chipmc/Trail-Traffic-Counter-Board-v10/Trail-Traffic-Counter-Board-v10.brd

## EAGLE design Trail-Traffic-Counter-Board-v10.brd (2017-07-19)

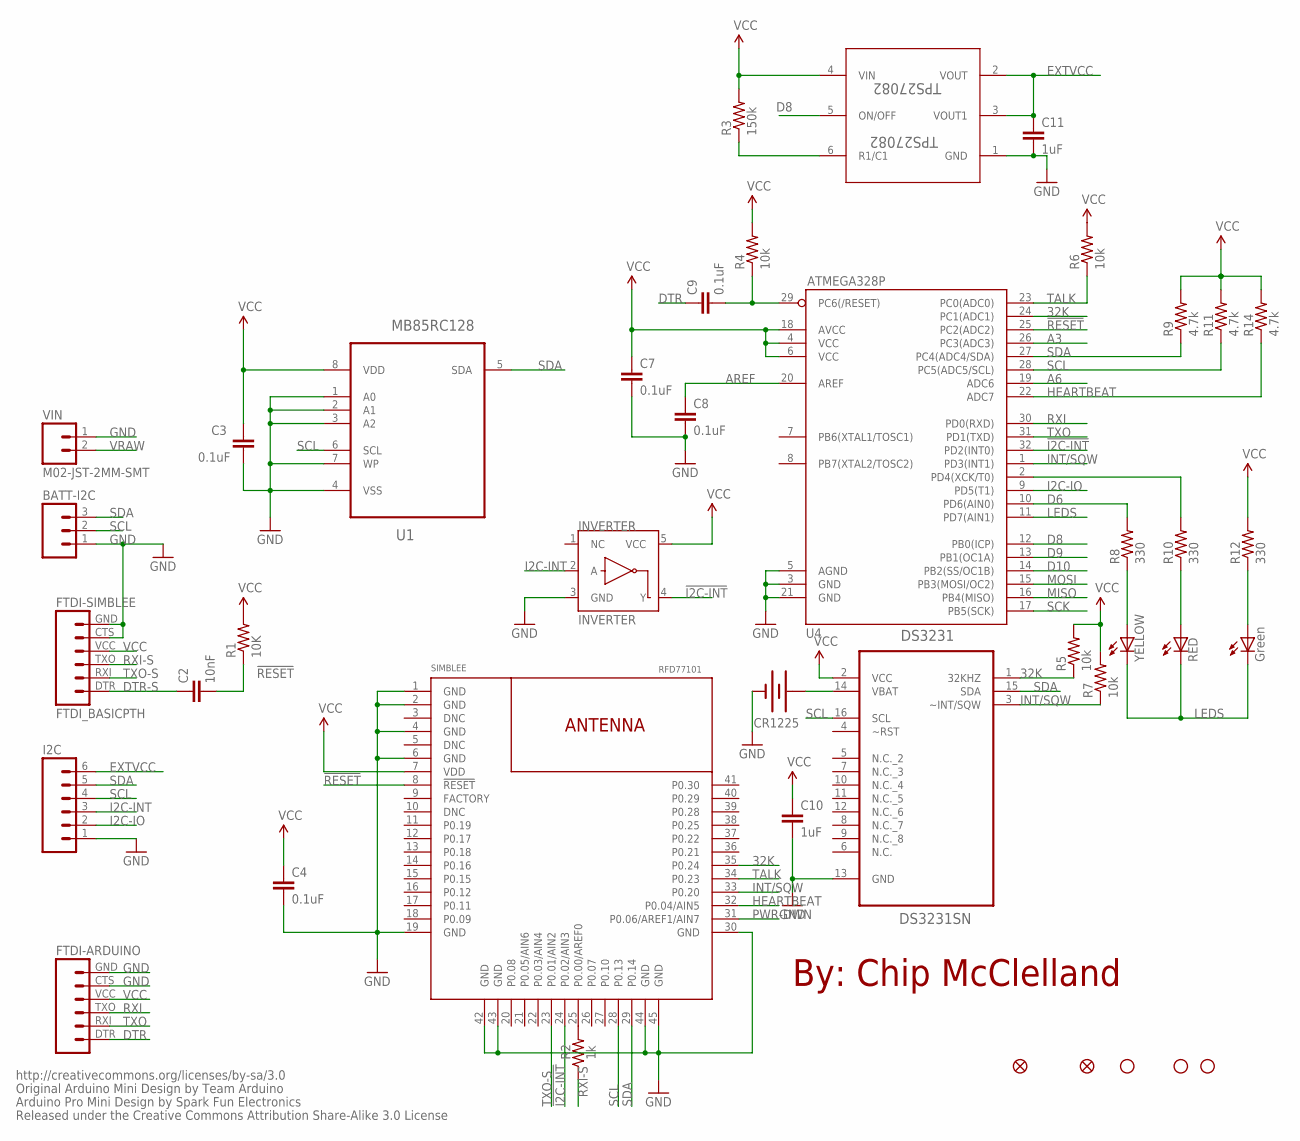
[picture p1: schematic Trail-Traffic-Counter-Board-v10.sch, sheet 1]

Parts:
ATMEGA328P: U4; TQFP32-08
BATT-I2C: M03LOCK; 1X03_LOCK
C2: 10nF; 0805
C3, C4, C7, C8, C9: 0.1uF; 0805
C10, C11: 1uF; 0805
CR1225: BATTERY12MM; BATTCON_12MM
DS3231: DS3231SN; SOIC127P1032X265-16N
FID1, FID2: FIDUCIALUFIDUCIAL; MICRO-FIDUCIAL
FTDI-ARDUINO: FTDI Basic; FTDI_BASIC
FTDI-SIMBLEE: FTDI_BASICPTH; FTDI_BASIC
I2C: M06LOCK; 1X06_LOCK
INVERTER: INVERTER; SOT23-5
JP6, JP7, JP8: STAND-OFF
LED1: YELLOW; CHIPLED_0805
LED2: RED; CHIPLED_0805
MB85RC128: U1; SOIC127P600X175-8N
PWR: Green; CHIPLED_0805
R1: 10K; 0805
R2: 1k; 0805
R3: 150k; 0805
R4, R5, R6, R7: 10k; 0805
R8, R10, R12: 330; 0603-RES
R9, R11, R14: 4.7k; 0805
SIMBLEE: RFD77101
TPS27082: TPS27082; TSOT-23
VIN: M02-JST-2MM-SMT; JST-2-SMD

Connections:
32K: ATMEGA328P.24 (PC1(ADC1)), DS3231.1 (32KHZ), R5.1, SIMBLEE.35 (P0.24)
!I2C-INT: ATMEGA328P.32 (PD2(INT0)), INVERTER.4 (Y), SIMBLEE.24 (P0.02/AIN3)
!RESET: ATMEGA328P.25 (PC2(ADC2)), C2.2, R1.1, SIMBLEE.8 (!RESET!)
A3: ATMEGA328P.26 (PC3(ADC3))
A6: ATMEGA328P.19 (ADC6)
AREF: ATMEGA328P.20 (AREF), C8.1
D6: ATMEGA328P.10 (PD6(AIN0)), R8.2
D8: ATMEGA328P.12 (PB0(ICP)), TPS27082.5 (ON/OFF)
D9: ATMEGA328P.13 (PB1(OC1A))
D10: ATMEGA328P.14 (PB2(SS/OC1B))
DTR: C9.1, FTDI-ARDUINO.DTR (1)
DTR-S: C2.1, FTDI-SIMBLEE.DTR (1)
EXTVCC: C11.1, I2C.6, TPS27082.2 (VOUT), TPS27082.3 (VOUT1)
GND: ATMEGA328P.3 (GND), ATMEGA328P.5 (AGND), ATMEGA328P.21 (GND), BATT-I2C.1, C3.2, C4.2, C7.2, C8.2, C10.2, C11.2, CR1225.GND (-), DS3231.13 (GND), FTDI-ARDUINO.CTS (5), FTDI-ARDUINO.GND (6), FTDI-SIMBLEE.CTS (5), FTDI-SIMBLEE.GND (6), I2C.1, INVERTER.3 (GND), MB85RC128.1 (A0), MB85RC128.2 (A1), MB85RC128.3 (A2), MB85RC128.4 (VSS), MB85RC128.7 (WP), SIMBLEE.1 (GND), SIMBLEE.2 (GND), SIMBLEE.4 (GND), SIMBLEE.6 (GND), SIMBLEE.19 (GND), SIMBLEE.30 (GND), SIMBLEE.42 (GND), SIMBLEE.43 (GND), SIMBLEE.44 (GND), SIMBLEE.45 (GND), TPS27082.1 (GND), VIN.1 (2); also elsewhere on the board
HEARTBEAT: ATMEGA328P.22 (ADC7), R14.1, SIMBLEE.32 (P0.04/AIN5)
I2C-INT: I2C.3, INVERTER.2 (A)
I2C-IO: ATMEGA328P.9 (PD5(T1)), I2C.2
INT/SQW: ATMEGA328P.1 (PD3(INT1)), DS3231.3 (~INT/SQW), R7.1, SIMBLEE.33 (P0.20)
LEDS: ATMEGA328P.11 (PD7(AIN1)), LED1.C, LED2.C, PWR.C
MISO: ATMEGA328P.16 (PB4(MISO))
MOSI: ATMEGA328P.15 (PB3(MOSI/OC2))
unnamed: LED1.A, R8.1
unnamed: ATMEGA328P.2 (PD4(XCK/T0)), R10.2
unnamed: LED2.A, R10.1
unnamed: R3.1, TPS27082.6 (R1/C1)
unnamed: R2.2, SIMBLEE.25 (P0.00/AREF0)
unnamed: PWR.A, R12.1
PWR-DWN: SIMBLEE.31 (P0.06/AREF1/AIN7); also elsewhere on the board
RESET: ATMEGA328P.29 (PC6(/RESET)), C9.2, R4.1
RXI: ATMEGA328P.30 (PD0(RXD)), FTDI-ARDUINO.TXO (3)
RXI-S: FTDI-SIMBLEE.TXO (3), R2.1
SCK: ATMEGA328P.17 (PB5(SCK))
SCL: ATMEGA328P.28 (PC5(ADC5/SCL)), BATT-I2C.2, DS3231.16 (SCL), I2C.4, MB85RC128.6 (SCL), R11.1, SIMBLEE.28 (P0.13)
SDA: ATMEGA328P.27 (PC4(ADC4/SDA)), BATT-I2C.3, DS3231.15 (SDA), I2C.5, MB85RC128.5 (SDA), R9.1, SIMBLEE.29 (P0.14)
TALK: ATMEGA328P.23 (PC0(ADC0)), R6.1, SIMBLEE.34 (P0.23)
TXO: ATMEGA328P.31 (PD1(TXD)), FTDI-ARDUINO.RXI (2)
TXO-S: FTDI-SIMBLEE.RXI (2), SIMBLEE.23 (P0.01/AIN2)
VBAT: CR1225.PWR@1 (+), DS3231.14 (VBAT)
VCC: ATMEGA328P.4 (VCC), ATMEGA328P.6 (VCC), ATMEGA328P.18 (AVCC), C3.1, C4.1, C7.1, C10.1, DS3231.2 (VCC), FTDI-ARDUINO.VCC (4), FTDI-SIMBLEE.VCC (4), INVERTER.5 (VCC), MB85RC128.8 (VDD), R1.2, R3.2, R4.2, R5.2, R6.2, R7.2, R9.2, R11.2, R12.2, R14.2, SIMBLEE.7 (VDD), TPS27082.4 (VIN); also elsewhere on the board
VRAW: VIN.2 (1); also elsewhere on the board

Notes on the sheet:
Released under the Creative Commons Attribution Share-Alike 3.0 License
http://creativecommons.org/licenses/by-sa/3.0
Original Arduino Mini Design by Team Arduino
Arduino Pro Mini Design by Spark Fun Electronics
By: Chip McClelland

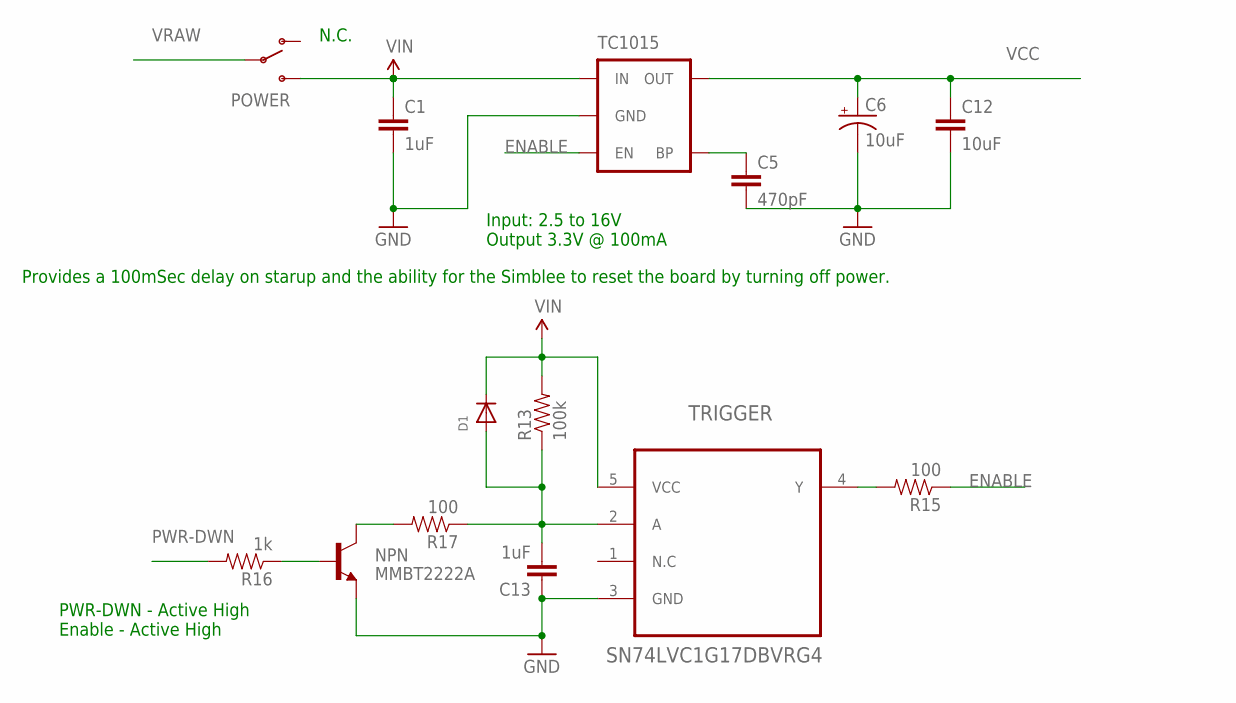
[picture p2: schematic Trail-Traffic-Counter-Board-v10.sch, sheet 2]

Parts:
C1, C13: 1uF; 0805
C5: 470pF; 0805
C6: 10uF; EIA3216
C12: 10uF; 0805
D1: DIODESOD-523; SOD-523
NPN: MMBT2222A; SOT23-3
POWER: SWITCH-SPDTPTH; SWITCH-SPDT
R13: 100k; 0805
R15, R17: 100; 0805
R16: 1k; 0805
TC1015: MIC52053.3V; SOT23-5
TRIGGER: SN74LVC1G17DBVRG4; SOT95P280X145-5N

Connections:
ENABLE: R15.1, TC1015.3 (EN)
GND: C1.2, C5.2, C6.C (-), C12.2, C13.1, NPN.2 (E), TC1015.2 (GND), TRIGGER.3 (GND); also elsewhere on the board
unnamed: C5.1, TC1015.4 (BP)
unnamed: C13.2, D1.A, R13.1, R17.1, TRIGGER.2 (A)
unnamed: R15.2, TRIGGER.4 (Y)
unnamed: NPN.1 (B), R16.1
unnamed: NPN.3 (C), R17.2
PWR-DWN: R16.2; also elsewhere on the board
VCC: C6.A (+), C12.1, TC1015.5 (OUT); also elsewhere on the board
VIN: C1.1, D1.K (C), POWER.3 (S), R13.2, TC1015.1 (IN), TRIGGER.5 (VCC)
VRAW: POWER.2; also elsewhere on the board

Notes on the sheet:
Input: 2.5 to 16V Output 3.3V @ 100mA
N.C.
PWR-DWN - Active High Enable - Active High
Provides a 100mSec delay on starup and the ability for the Simblee to reset the board by turning off power.

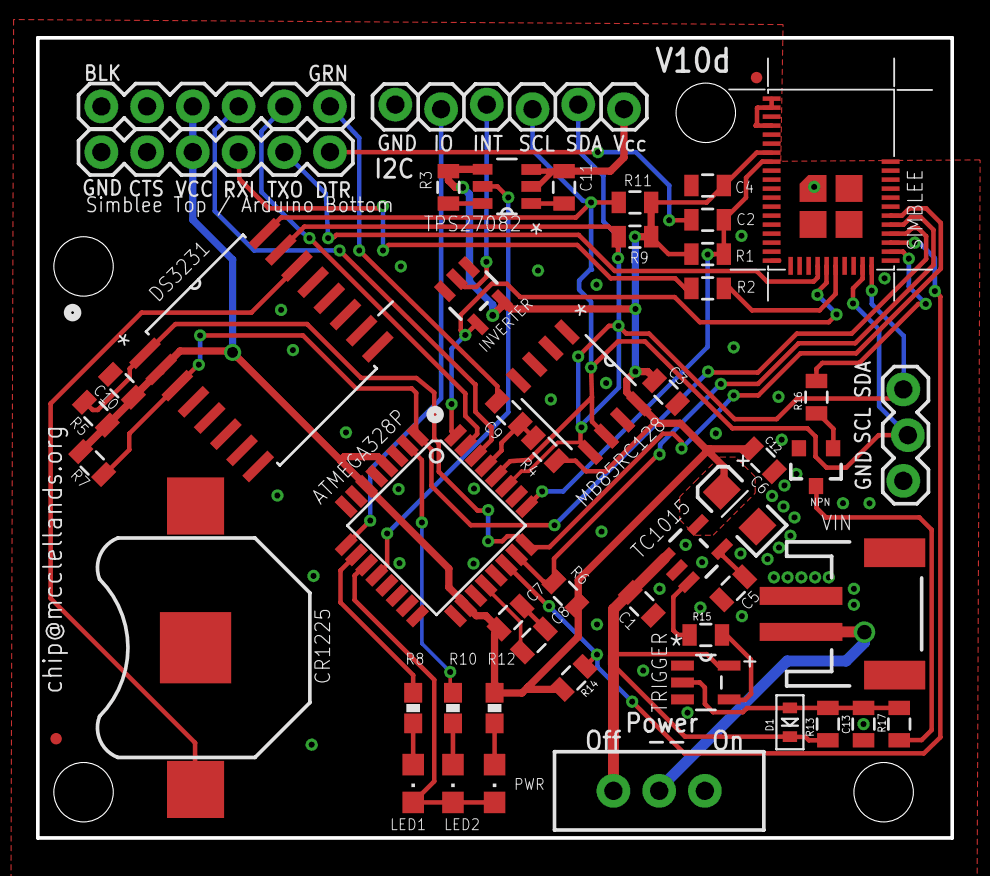
[picture p3: board Trail-Traffic-Counter-Board-v10.brd from above]

Board: 2 copper layers, 50.8 x 44.5 mm, 56 parts (0 on the bottom side), 40 nets.

Other parts of the board:
JP2: STAND-OFF
