chipmc/Trail-Traffic-Counter-Board-v10/(commit log)

2016-08-26 First Rev for v10
    v10 adds the ability to turn on an off the Vcc pin on the external i2c
    header.
    [Trail-Traffic-Counter-Board-v10.brd, Trail-Traffic-Counter-Board-v10.sch]
2016-09-13 Updated the design to include an on-off for the external i2c port
    [Trail-Traffic-Counter-Board-v10.brd]
2017-07-19 Latest Design
    [Trail-Traffic-Counter-Board-v10.brd, Trail-Traffic-Counter-Board-v10.sch]
